tetradsensors/airu-board/README.md

# airu-board

This repo hold the AirU PCB
