tetradsensors/airu-board/eagle-lib/README.md

# AirUv2.1 Schematic and Layout

Last Modified: November 12, 2018 by Trenton Taylor
