tetradsensors/airu-board/eagle-lib/AirU_v2.2.brd

## EAGLE design eagle-lib/AirU_v2.2.brd (2020-07-23)

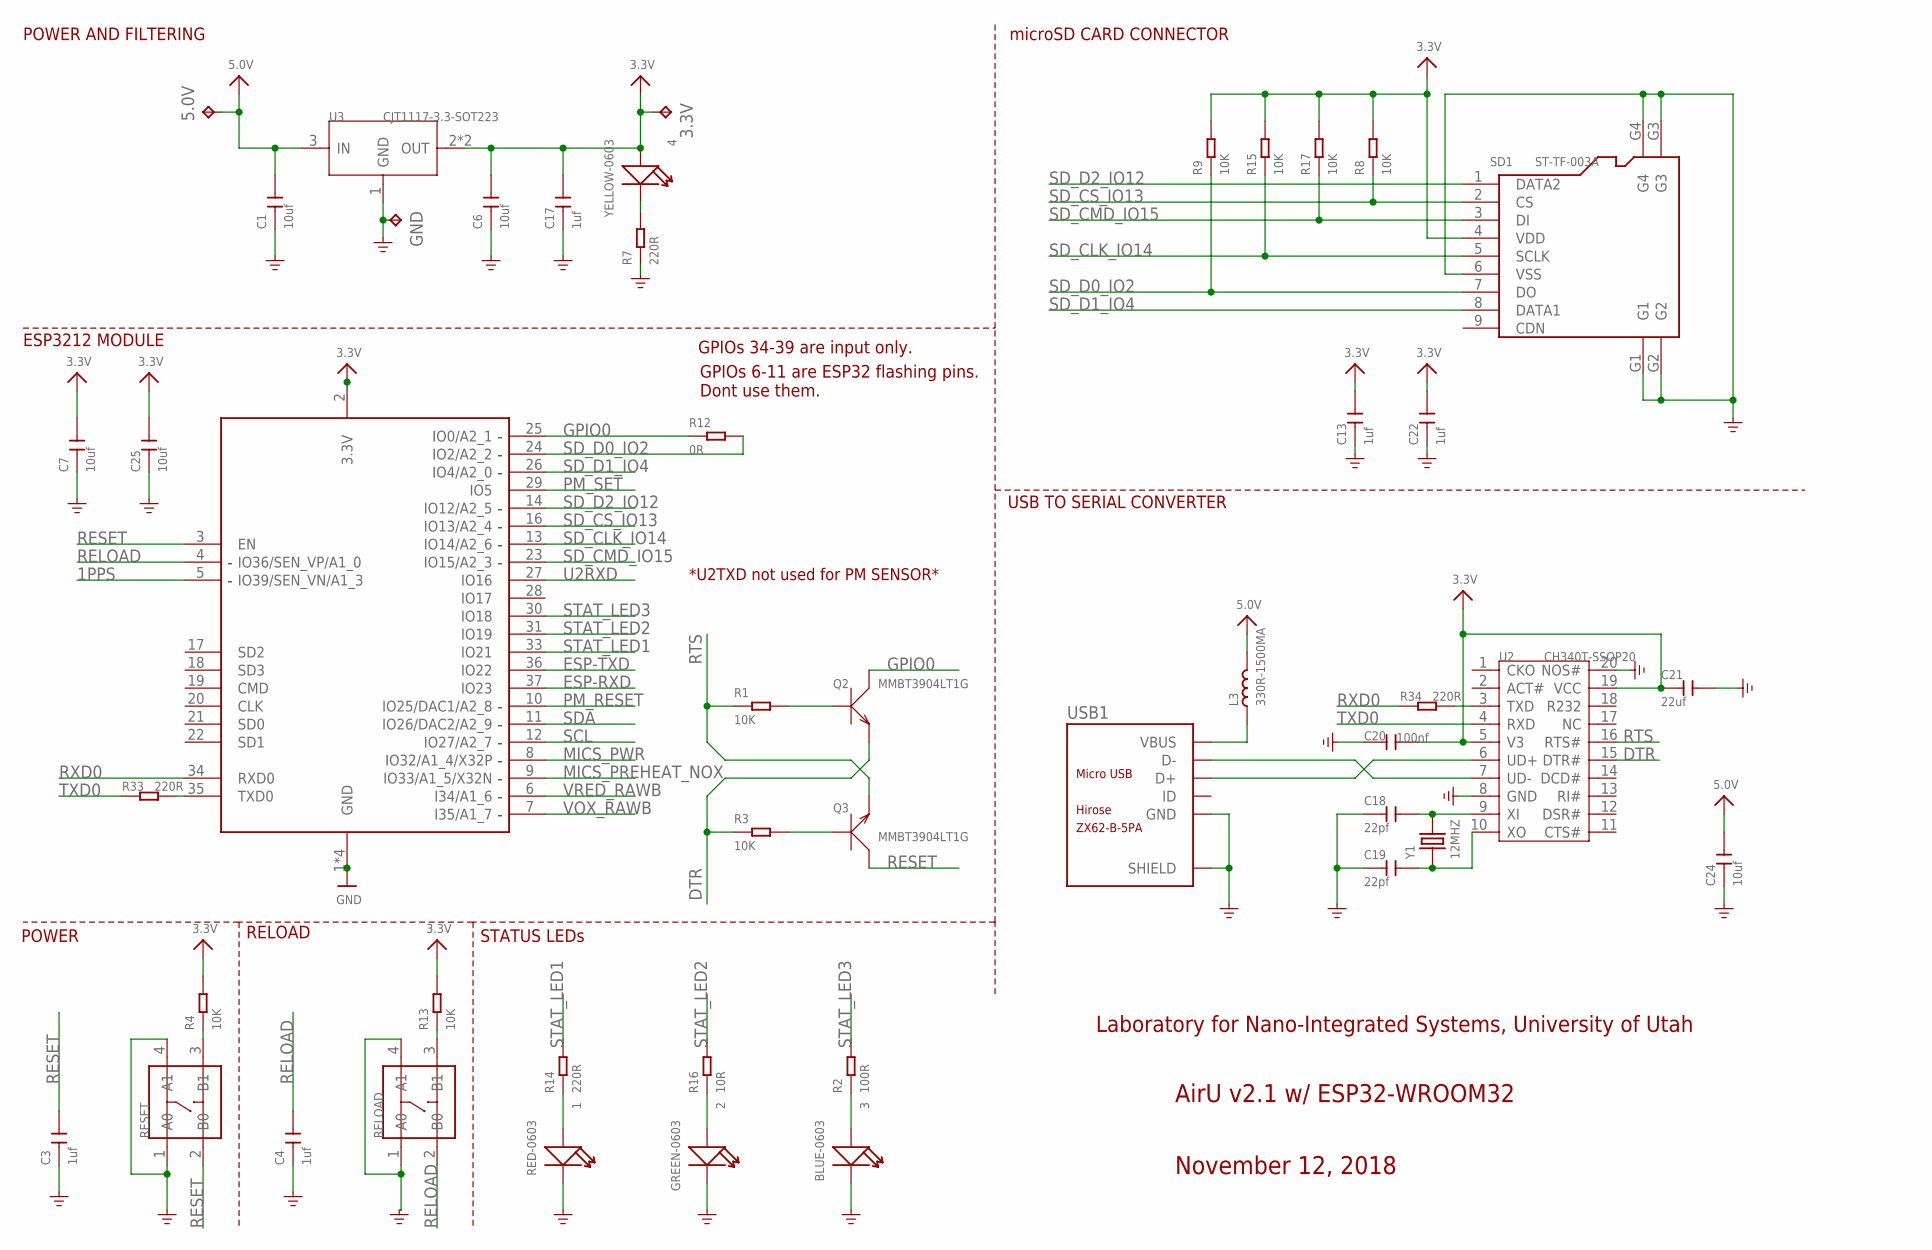
[picture p1: schematic AirU_v2.2.sch, sheet 1]

Parts:
1: RED-0603; LED-0603
2: GREEN-0603; LED-0603
3: BLUE-0603; LED-0603
3.3V, 5.0V: TPTP20SQ; TP20SQ
4: YELLOW-0603; LED-0603
C1, C6, C7, C24, C25: 10uf; C0603
C3, C4, C13, C17, C22: 1uf; C0603
C18, C19: 22pf; C0603
C20: 100nf; C0603
C21: 22uf; C0805
GND: TPTP20SQ; TP20SQ
L3: 330R-1500MA; L0805
Q2, Q3: MMBT3904LT1G; SOT-23
R1, R3, R4, R8, R9, R13, R15, R17: 10K; R0603
R2: 100R; R0603
R7, R14, R33, R34: 220R; R0603
R12: 0R; R0603
R16: 10R; R0603
RELOAD: DIP-SWITCH-TACTILE-SPST-NO/TS-1109(4P-D6.0MM)'TS-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; SW4-6.0X6.0X5.0MM
RESET: DIP-SWITCH-TACTILE-SPST-NO/TS-1109(4P-D6.0MM)'TS-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; SW4-6.0X6.0X5.0MM
SD1: ST-TF-003A; MICRO-SD9+4P-SMD-16.1X14.5X1.85MM
U2: CH340T-SSOP20; SSOP20-0.65-7.6X5.2MM
U3: CJT1117-3.3-SOT223; SOT-223
U7: ESP32_WROOM32_SKINNY; WROOM32_SKINNY
USB1: ZX62-B-5PA; MICRO-USB5+6P-SMD-0.65-AB
Y1: 12MHZ; X2-SMD-5.0X3.2X1.3MM

Connections:
1PPS: U7.5 (IO39/SEN_VN/A1_3); also elsewhere on the board
3.3V: 3.3V.TP, 4.+, C6.2, C7.2, C13.2, C17.2, C20.2, C21.1, C22.2, C25.2, R4.2, R8.2, R9.2, R13.2, R15.2, R17.2, SD1.4 (VDD), U2.5 (V3), U2.19 (VCC), U3.2 (OUT), U3.TER (OUT), U7.2 (3.3V); also elsewhere on the board
5.0V: 5.0V.TP, C1.2, C24.2, L3.2, U3.3 (IN); also elsewhere on the board
DTR: Q2.2 (E), R3.1, U2.15 (DTR#)
ESP-RXD: U7.37 (IO23); also elsewhere on the board
ESP-TXD: U7.36 (IO22); also elsewhere on the board
GND: 1.-, 2.-, 3.-, C1.1, C3.1, C4.1, C6.1, C7.1, C13.1, C17.1, C18.1, C19.1, C20.1, C21.2, C22.1, C24.1, C25.1, GND.TP, R7.1, RELOAD.1 (A0), RELOAD.4 (A1), RESET.1 (A0), RESET.4 (A1), SD1.6 (VSS), SD1.G1, SD1.G2, SD1.G3, SD1.G4, U2.8 (GND), U2.20 (NOS#), U3.1 (GND), U7.1 (GND), U7.15 (GND), U7.38 (GND), U7.P$1 (GND), USB1.5 (GND), USB1.P1 (SHIELD), USB1.P2 (SHIELD), USB1.P3_1 (SHIELD), USB1.P3_2 (SHIELD), USB1.P3_3 (SHIELD), USB1.P4_1 (SHIELD), USB1.P4_2 (SHIELD), USB1.P4_3 (SHIELD), USB1.P5 (SHIELD), USB1.P6 (SHIELD); also elsewhere on the board
GPIO0: Q2.3 (C), R12.1, U7.25 (IO0/A2_1)
MICS_PREHEAT_NOX: U7.9 (IO33/A1_5/X32N); also elsewhere on the board
MICS_PWR: U7.8 (IO32/A1_4/X32P); also elsewhere on the board
unnamed: 2.+, R16.1
unnamed: 1.+, R14.1
unnamed: Q3.1 (B), R3.2
unnamed: Q2.1 (B), R1.2
unnamed: 3.+, R2.1
unnamed: 4.-, R7.2
unnamed: U2.7 (UD-), USB1.2 (D-)
unnamed: U2.6 (UD+), USB1.3 (D+)
unnamed: C18.2, U2.9 (XI), Y1.2
unnamed: C19.2, U2.10 (XO), Y1.1
unnamed: R34.2, U2.3 (TXD)
unnamed: R33.2, U7.35 (TXD0)
unnamed: R13.1, RELOAD.3 (B1)
unnamed: R4.1, RESET.3 (B1)
PM_RESET: U7.10 (IO25/DAC1/A2_8); also elsewhere on the board
PM_SET: U7.29 (IO5); also elsewhere on the board
RELOAD: C4.2, RELOAD.2 (B0), U7.4 (IO36/SEN_VP/A1_0)
RESET: C3.2, Q3.3 (C), RESET.2 (B0), U7.3 (EN)
RTS: Q3.2 (E), R1.1, U2.16 (RTS#)
RXD0: R34.1, U7.34 (RXD0)
SCL: U7.12 (IO27/A2_7); also elsewhere on the board
SDA: U7.11 (IO26/DAC2/A2_9); also elsewhere on the board
SD_CLK_IO14: R15.1, SD1.5 (SCLK), U7.13 (IO14/A2_6)
SD_CMD_IO15: R17.1, SD1.3 (DI), U7.23 (IO15/A2_3)
SD_CS_IO13: R8.1, SD1.2 (CS), U7.16 (IO13/A2_4)
SD_D0_IO2: R9.1, R12.2, SD1.7 (DO), U7.24 (IO2/A2_2)
SD_D1_IO4: SD1.8 (DATA1), U7.26 (IO4/A2_0)
SD_D2_IO12: SD1.1 (DATA2), U7.14 (IO12/A2_5)
STAT_LED1: R14.2, U7.33 (IO21)
STAT_LED2: R16.2, U7.31 (IO19)
STAT_LED3: R2.2, U7.30 (IO18)
TXD0: R33.1, U2.4 (RXD)
U2RXD: U7.27 (IO16); also elsewhere on the board
VBUS: L3.1, USB1.1 (VBUS)
VOX_RAWB: U7.7 (I35/A1_7); also elsewhere on the board
VRED_RAWB: U7.6 (I34/A1_6); also elsewhere on the board

Notes on the sheet:
POWER AND FILTERING
RELOAD
USB TO SERIAL CONVERTER
ESP3212 MODULE
POWER
microSD CARD CONNECTOR
AirU v2.1 w/ ESP32-WROOM32
November 12, 2018
STATUS LEDs
*U2TXD not used for PM SENSOR*
GPIOs 34-39 are input only.
Laboratory for Nano-Integrated Systems, University of Utah
GPIOs 6-11 are ESP32 flashing pins. Dont use them.

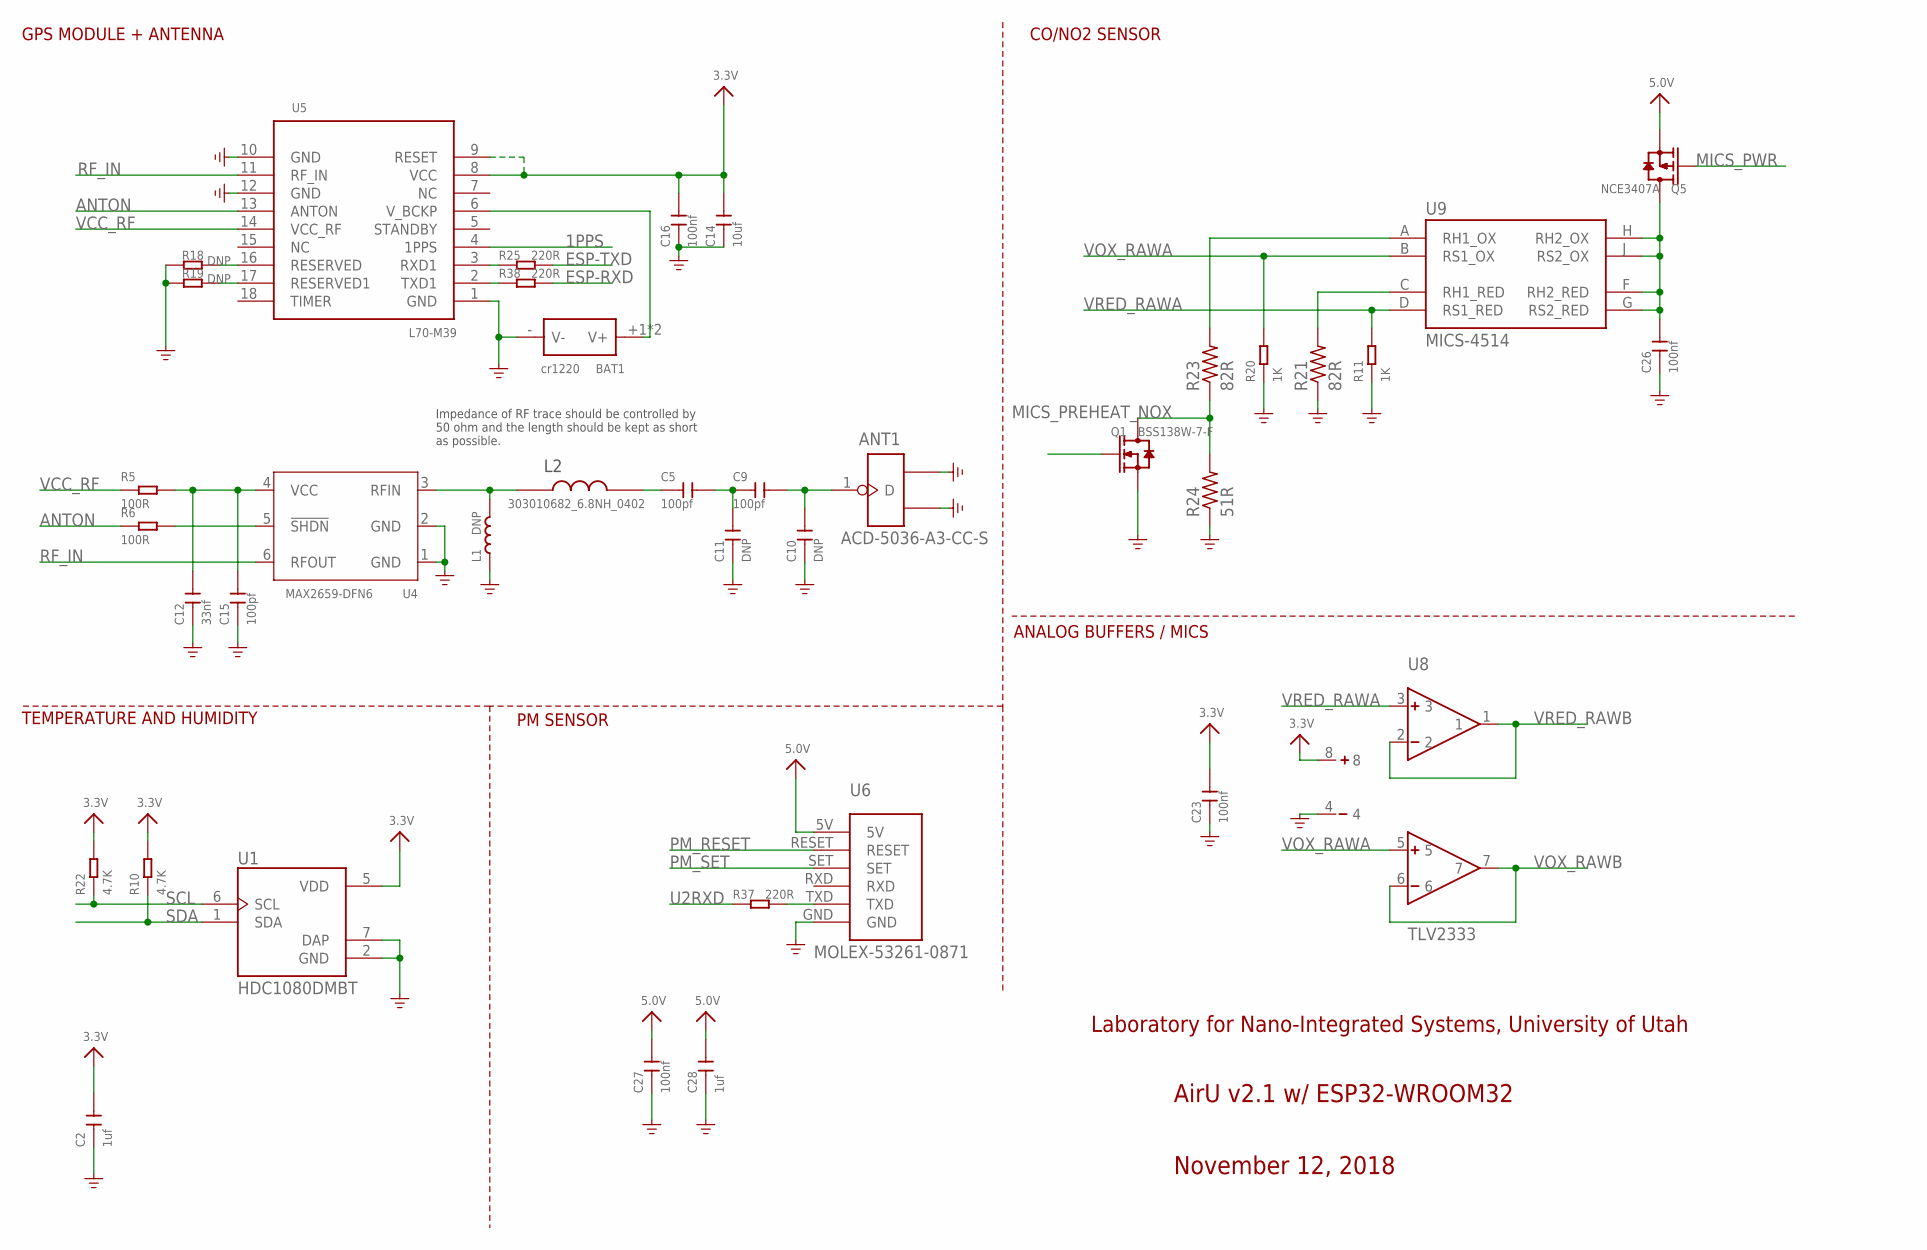
[picture p2: schematic AirU_v2.2.sch, sheet 2]

Parts:
ANT1: ACD-5036-A3-CC-S; ANT3-SMD-5.2X3.7X0.7MM
BAT1: cr1220; BAT2P-13.5-CR1220
C2, C28: 1uf; C0603
C5, C9, C15: 100pf; C0603
C10, C11: DNP; C0603
C12: 33nf; C0603
C14: 10uf; C0603
C16, C23, C26, C27: 100nf; C0603
L1: DNP; L0201
L2: 303010682_6.8NH_0402; L0402
Q1: BSS138W-7-F; SOT-23
Q5: NCE3407A; SOT-23
R5, R6: 100R; R0603
R10, R22: 4.7K; R0603
R11, R20: 1K; R0603
R18, R19: DNP; R0603
R21, R23: 82R; R0603
R24: 51R; R0603
R25, R37, R38: 220R; R0603
U1: HDC1080DMBT; SON100P300X300X80-7N
U4: MAX2659-DFN6; DFN6-0.5-1.5X1.2X0.72MM
U5: L70-M39; LGA18-1.1-9.7X10.1X2.5MM
U6: MOLEX-53261-0871
U8: TLV2333
U9: MICS-4514; MICS_10-SMD

Connections:
1PPS: U5.4 (1PPS); also elsewhere on the board
3.3V: C2.2, C14.2, C16.2, C23.2, R10.2, R22.2, U1.5 (VDD), U5.8 (VCC), U5.9 (RESET), U8.8; also elsewhere on the board
5.0V: C27.2, C28.2, Q5.2 (S), U6.5V; also elsewhere on the board
ANTON: R6.1, U5.13 (ANTON)
ESP-RXD: R38.2; also elsewhere on the board
ESP-TXD: R25.2; also elsewhere on the board
GND: ANT1.2 (GND1), ANT1.3 (GND2), BAT1.- (V-), C2.1, C10.1, C11.1, C12.1, C14.1, C15.1, C16.1, C23.1, C26.1, C27.1, C28.1, L1.1, Q1.2 (S), R11.1, R18.1, R19.1, R20.1, R21.1, R24.1, U1.2 (GND), U1.7 (DAP), U4.1 (GND), U4.2 (GND), U5.1 (GND), U5.10 (GND), U5.12 (GND), U6.GND, U8.4; also elsewhere on the board
MICS_PREHEAT_NOX: Q1.1 (G); also elsewhere on the board
MICS_PWR: Q5.1 (G); also elsewhere on the board
unnamed: R21.2, U9.C (RH1_RED)
unnamed: C5.2, C9.1, C11.2
unnamed: ANT1.1 (D), C9.2, C10.2
unnamed: L1.2, L2.P$1, U4.3 (RFIN)
unnamed: R23.2, U9.A (RH1_OX)
unnamed: C5.1, L2.P$2
unnamed: R6.2, U4.5 (!SHDN)
unnamed: C12.2, C15.2, R5.2, U4.4 (VCC)
unnamed: R18.2, U5.16 (RESERVED)
unnamed: R19.2, U5.17 (RESERVED1)
unnamed: Q1.3 (D), R23.1, R24.2
unnamed: C26.2, Q5.3 (D), U9.F (RH2_RED), U9.G (RS2_RED), U9.H (RH2_OX), U9.J (RS2_OX)
unnamed: R37.2, U6.TXD
PM_RESET: U6.RESET; also elsewhere on the board
PM_SET: U6.SET; also elsewhere on the board
RF_IN: U4.6 (RFOUT), U5.11 (RF_IN)
SCL: R22.1, U1.6 (SCL); also elsewhere on the board
SDA: R10.1, U1.1 (SDA); also elsewhere on the board
U1RXD: R25.1, U5.3 (RXD1)
U1TXD: R38.1, U5.2 (TXD1)
U2RXD: R37.1; also elsewhere on the board
VCC_RF: R5.1, U5.14 (VCC_RF)
VOX_RAWA: R20.2, U8.5, U9.B (RS1_OX)
VOX_RAWB: U8.6, U8.7; also elsewhere on the board
VRED_RAWA: R11.2, U8.3, U9.D (RS1_RED)
VRED_RAWB: U8.1, U8.2; also elsewhere on the board
V_BCKP: BAT1.+1 (V+), BAT1.+2 (V+), U5.6 (V_BCKP)

Notes on the sheet:
PM SENSOR
Impedance of RF trace should be controlled by 50 ohm and the length should be kept as short as possible.
TEMPERATURE AND HUMIDITY
GPS MODULE + ANTENNA
CO/NO2 SENSOR
AirU v2.1 w/ ESP32-WROOM32
November 12, 2018
ANALOG BUFFERS / MICS
Laboratory for Nano-Integrated Systems, University of Utah

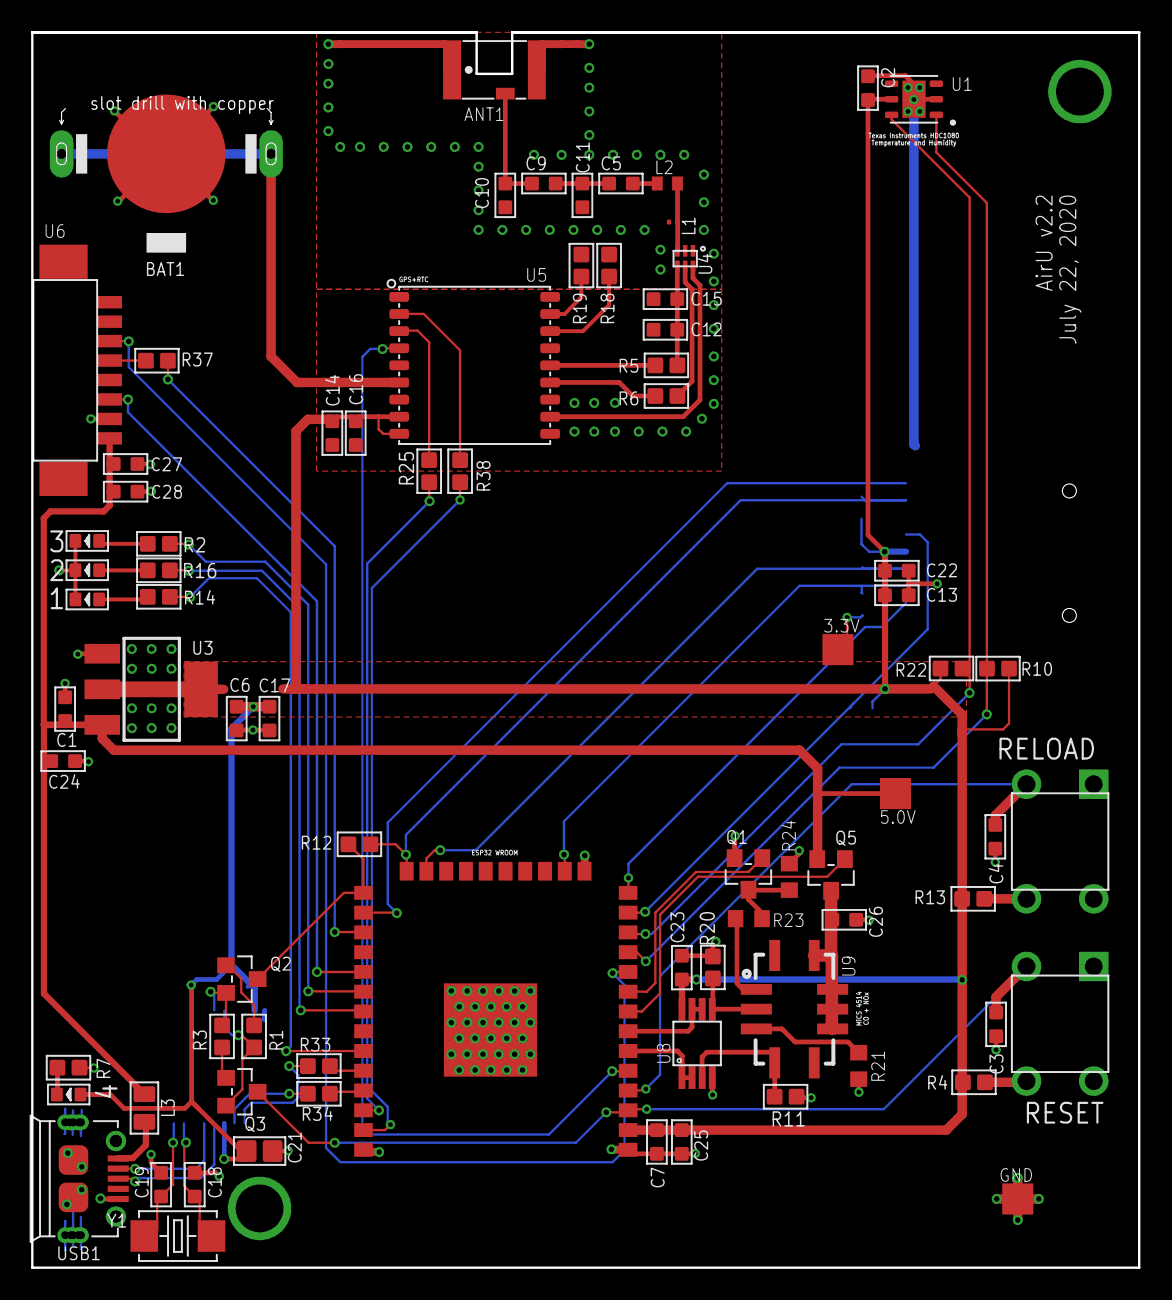
[picture p3: board AirU_v2.2.brd from above]

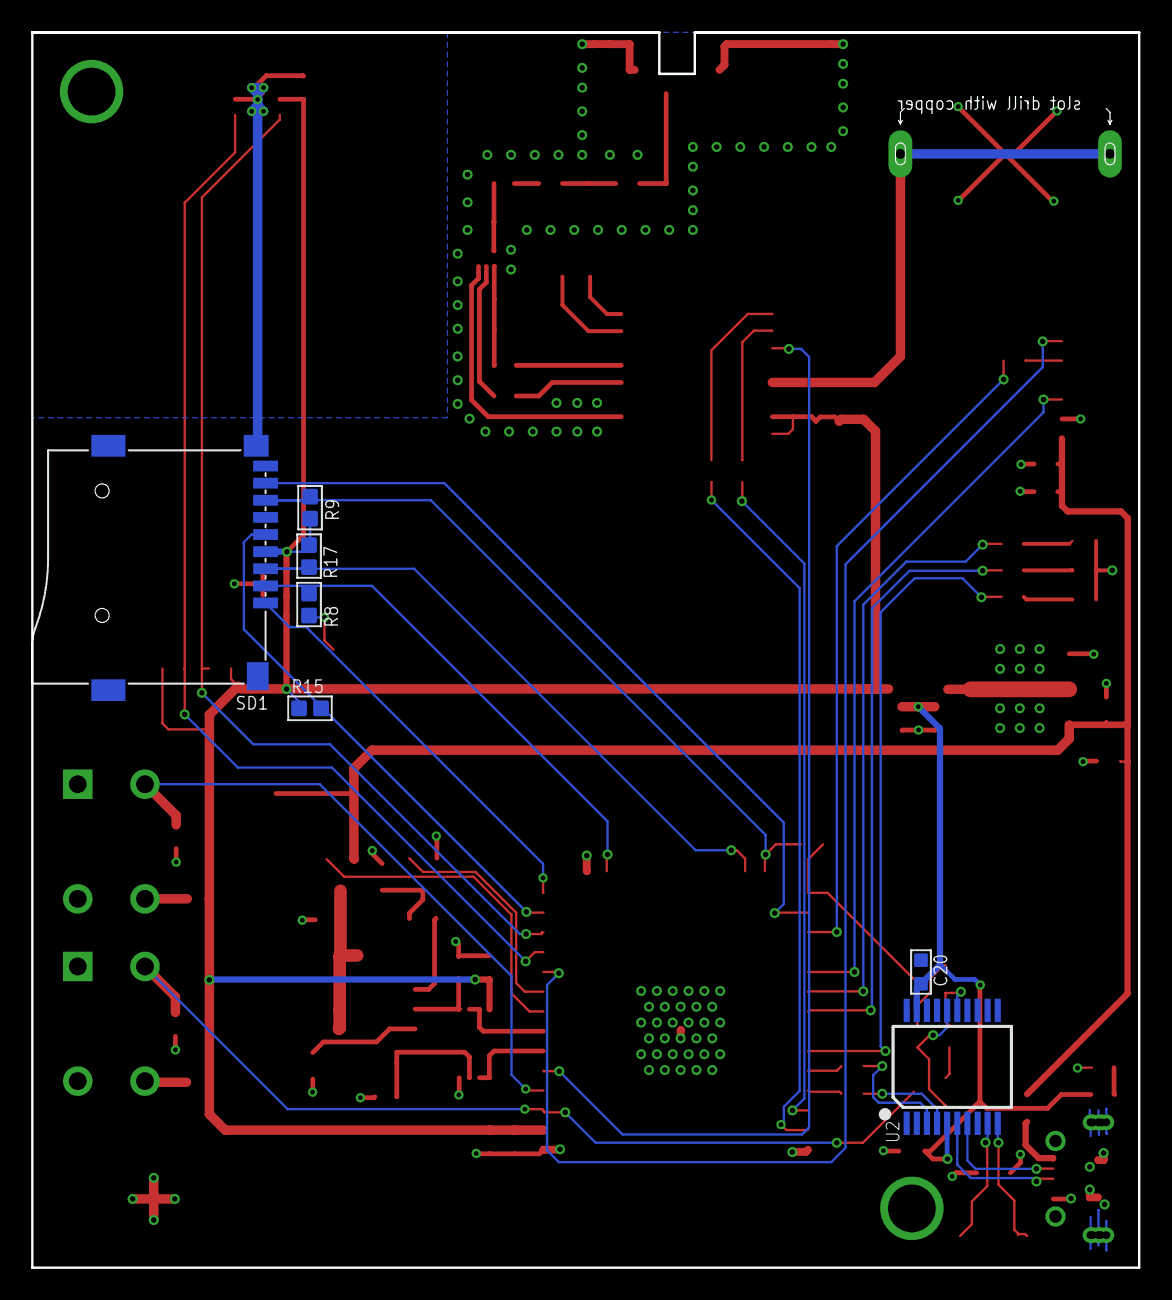
[picture p4: board AirU_v2.2.brd from below]

Board: 2 copper layers, 71.1 x 79.4 mm, 86 parts (7 on the bottom side), 67 nets.
