tetradsensors/airu-board/(commit log)

2019-04-26 updated board files to one-sided board
    [AirU_v2.0.GBL, AirU_v2.0.GBO, AirU_v2.0.GBP, AirU_v2.0.GBS, AirU_v2.0.GTL, AirU_v2.0.GTO, AirU_v2.0.GTP, AirU_v2.0.GTS]
2019-04-26 removed awesome graphic
    [WAirU_v1.1.brd]
2019-04-26 added keepout on temperature sensor
2019-04-29 renamed project
    [WAirU_v1.1.brd, WAirU_v1.1.sch]
2019-04-29 updated V2
    [AirU_v2.0.GBL, AirU_v2.0.GBO, AirU_v2.0.GBP, AirU_v2.0.GBS, AirU_v2.0.GTL, AirU_v2.0.GTO, AirU_v2.0.GTP, AirU_v2.0.GTS]
2019-09-11 updated to v2.1
    [AirU_v2.0.GBL, AirU_v2.0.GBO, AirU_v2.0.GBP, AirU_v2.0.GBS, AirU_v2.0.GTL, AirU_v2.0.GTO, AirU_v2.0.GTP, AirU_v2.0.GTS]
2020-07-23 removed airu logo
    also updated version text
    [AirU_v2.2.brd, AirU_v2.2.sch]
2020-07-23 board update
    PM SET/RESET moved to RTC GPIO pins, MiCS pins swapped to avoid cross-over, sd moved to bottom, usb-uart moved to bottom, gps moved, temp sensor moved to avoid overheating, 5v-3.3v converter moved, 3.3V rail size increased for heat dissipation, tetrad logo added, buttons moved
    [AirU_v2.2.brd, AirU_v2.2.sch]
